hieunguyenvd/250W-24V-to-48V-Synchronous-DC-DC-Boost-Converter-/3D Model.png

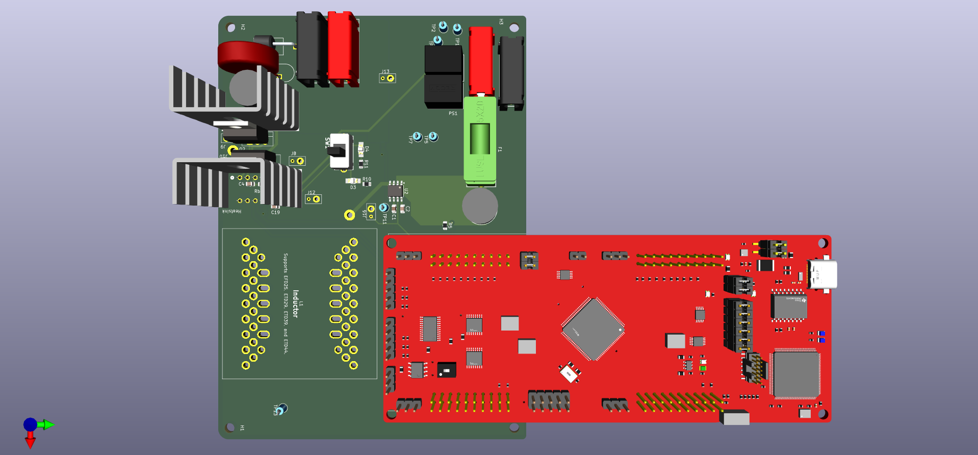
3D Model.png
