hieunguyenvd/250W-24V-to-48V-Synchronous-DC-DC-Boost-Converter-/Highlighted Overall Layout.png

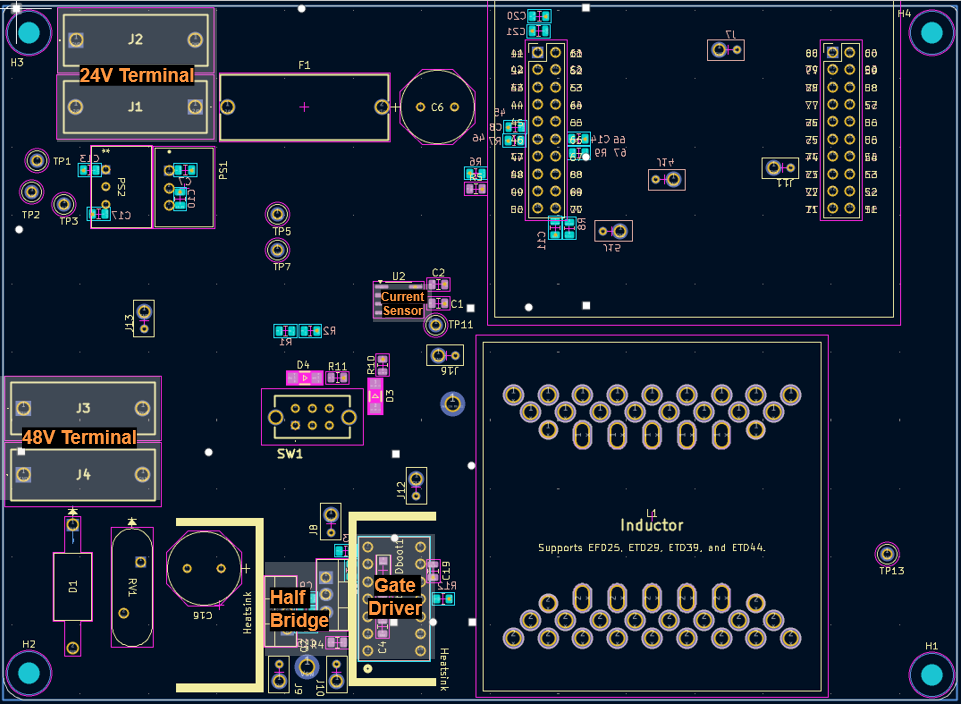
Highlighted Overall Layout.png
