hieunguyenvd/250W-24V-to-48V-Synchronous-DC-DC-Boost-Converter-/(list of files, cad)

Other CAD files:
adc_ex1_soc_epwm/CPU1_FLASH/f28p55x_codestartbranch.obj
adc_ex1_soc_epwm/CPU1_RAM/f28p55x_epwm.obj
adc_ex1_soc_epwm/CPU1_FLASH/f28p55x_sysctrl.obj
adc_ex1_soc_epwm/CPU1_RAM/f28p55x_usdelay.obj
adc_ex1_soc_epwm/CPU1_FLASH/f28p55x_usdelay.obj
adc_ex1_soc_epwm/CPU1_RAM/f28p55x_cputimers.obj
adc_ex1_soc_epwm/CPU1_FLASH/f28p55x_adc.obj
adc_ex1_soc_epwm/CPU1_RAM/f28p55x_pievect.obj
adc_ex1_soc_epwm/CPU1_FLASH/f28p55x_globalvariabledefs.obj
adc_ex1_soc_epwm/CPU1_RAM/f28p55x_sysctrl.obj
adc_ex1_soc_epwm/CPU1_FLASH/f28p55x_tempsensorconv.obj
adc_ex1_soc_epwm/CPU1_RAM/f28p55x_defaultisr.obj
adc_ex1_soc_epwm/CPU1_FLASH/f28p55x_defaultisr.obj
adc_ex1_soc_epwm/CPU1_RAM/f28p55x_tempsensorconv.obj
adc_ex1_soc_epwm/CPU1_FLASH/f28p55x_gpio.obj
adc_ex1_soc_epwm/CPU1_RAM/adc_ex1_soc_epwm.obj
adc_ex1_soc_epwm/CPU1_FLASH/adc_ex1_soc_epwm.obj
adc_ex1_soc_epwm/CPU1_RAM/f28p55x_adc.obj
adc_ex1_soc_epwm/CPU1_FLASH/f28p55x_dma.obj
adc_ex1_soc_epwm/CPU1_RAM/f28p55x_codestartbranch.obj
adc_ex1_soc_epwm/CPU1_FLASH/f28p55x_piectrl.obj
adc_ex1_soc_epwm/CPU1_RAM/f28p55x_globalvariabledefs.obj
adc_ex1_soc_epwm/CPU1_FLASH/f28p55x_cputimers.obj
adc_ex1_soc_epwm/CPU1_RAM/f28p55x_gpio.obj
adc_ex1_soc_epwm/CPU1_FLASH/f28p55x_epwm.obj
adc_ex1_soc_epwm/CPU1_RAM/f28p55x_piectrl.obj
adc_ex1_soc_epwm/CPU1_FLASH/f28p55x_pievect.obj
adc_ex1_soc_epwm/CPU1_RAM/f28p55x_dma.obj
