hieunguyenvd/250W-24V-to-48V-Synchronous-DC-DC-Boost-Converter-/Lab2_starter.kicad_pcb

## KiCad design Lab2_starter.kicad_pcb (2025-12-30)

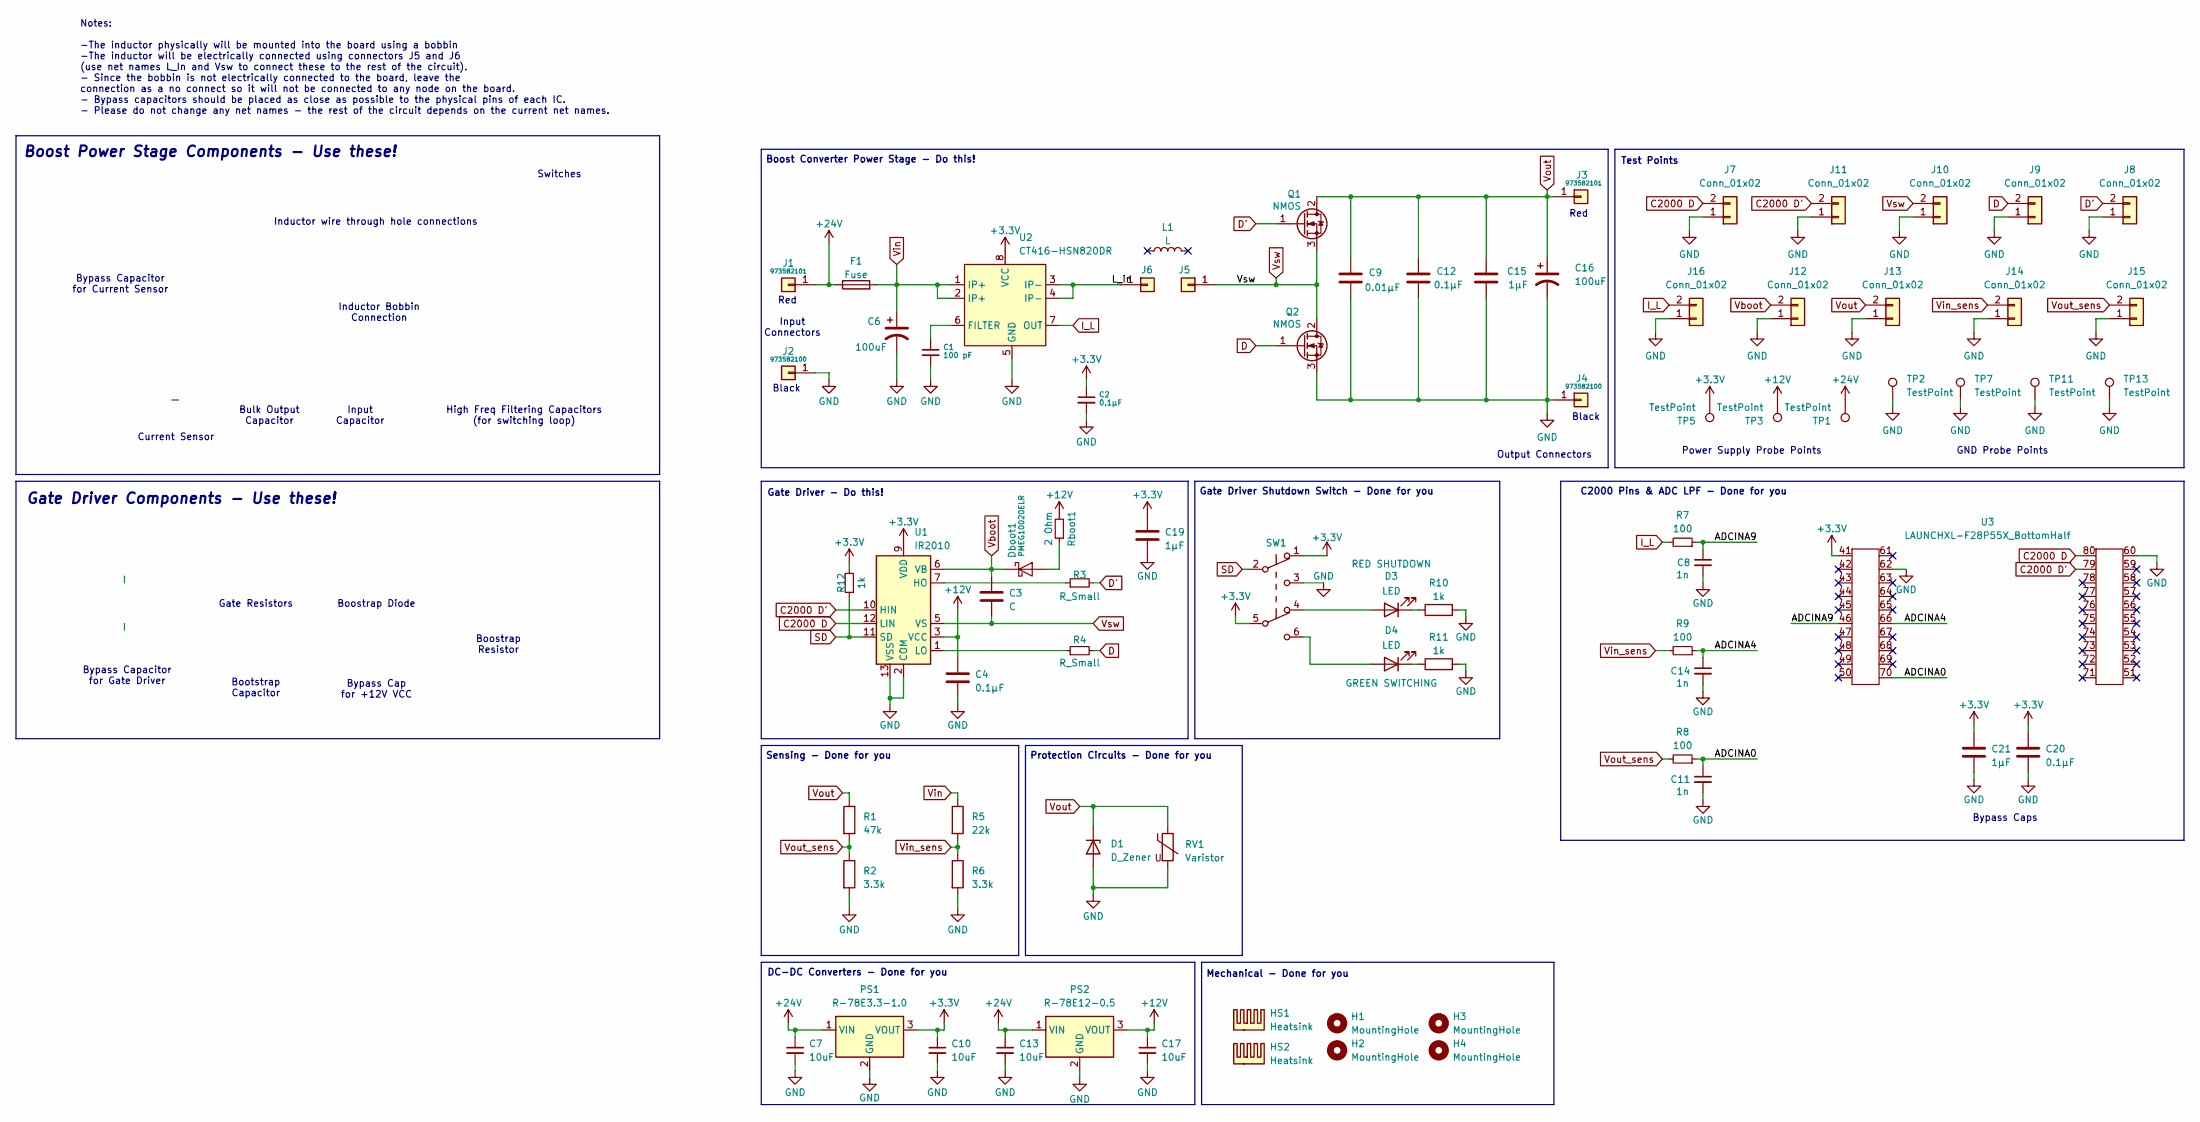
[picture p28: schematic Lab2_starter.kicad_sch, 24V-48V Boost Converter]

Parts:
C1: 100 pF; C_0805_2012Metric
C2, C4, C12, C20: 0.1μF; C_0805_2012Metric
C3: C; C_0805_2012Metric
C6, C16: 100uF; 16PX2200MEFC10X20
C7, C10, C13, C17: 10uF; C_0805_2012Metric
C8, C11, C14: 1n; C_0805_2012Metric
C9: 0.01μF; C_0805_2012Metric
C15, C19, C21: 1μF; C_0805_2012Metric
D1: D_Zener; 1.5KE75A
D3, D4: LED; WL-SMRW_1206_REC
Dboot1: PMEG10020ELR; Nexperia_CFP3_SOD-123W
F1: Fuse; 696108003002
H1, H2, H3, H4: MountingHole; MountingHole_3.2mm_M3
HS1, HS2: Heatsink; HSS-B20-NPS-01
J1, J3: 973582101
J2, J4: 973582100
J5, J6: Conn_01x01; Inductor_wire_conn
J7, J8, J9, J10, J11, J12, J13, J14, J15, J16: Conn_01x02; TP
L1: L; Inductor
PS1: R-78E3.3-1.0; PARTREV 6
PS2: R-78E12-0.5; R-78E-0.5_RCP
Q1, Q2: NMOS; TO-220-3_Vertical
R1: 47k; R_0805_2012Metric
R2, R6: 3.3k; R_0805_2012Metric
R3, R4: R_Small; R_0805_2012Metric
R5: 22k; R_0805_2012Metric
R7, R8, R9: 100; R_0805_2012Metric
R10, R11, R12: 1k; R_0805_2012Metric
RV1: Varistor; V100ZA15P
Rboot1: 2 Ohm; R_0805_2012Metric
SW1: SW_Push_DPDT; SLW1116297AD
TP1, TP2, TP3, TP5, TP7, TP11, TP13: TestPoint; TestPoint_Loop_D1.80mm_Drill1.0mm_Beaded
U1: IR2010; 1-2199298-3
U2: CT416-HSN820DR; SOIC-8_3.9x4.9mm_P1.27mm
U3: LAUNCHXL-F28P55X_BottomHalf

Connections:
+3.3V: C2.1, C10.1, C19.1, C20.1, C21.1, PS1.3 (VOUT), R12.2, SW1.1 (A), SW1.5 (B), TP5.1, U1.9 (VDD), U2.8 (VCC), U3.41
+12V: C4.1, C17.1, PS2.3 (VOUT), Rboot1.2, TP3.1, U1.3 (VCC)
+24V: C7.1, C13.1, F1.1, J1.1, PS1.1 (VIN), PS2.1 (VIN), TP1.1
/ADCINA0: C11.1, R8.1, U3.70
/ADCINA4: C14.1, R9.1, U3.66
/ADCINA9: C8.1, R7.1, U3.46
C2000 D: J7.2, U1.12 (LIN), U3.80
C2000 D': J11.2, U1.10 (HIN), U3.79
D: J9.2, Q2.1 (G), R4.2
D': J8.2, Q1.1 (G), R3.2
GND: C1.2, C2.2, C4.2, C6.2, C7.2, C8.2, C9.2, C10.2, C11.2, C12.2, C13.2, C14.2, C15.2, C16.2, C17.2, C19.2, C20.2, C21.2, D1.2 (A), J2.1, J4.1, J7.1, J8.1, J9.1, J10.1, J11.1, J12.1, J13.1, J14.1, J15.1, J16.1, PS1.2 (GND), PS2.2 (GND), Q2.3 (S), R2.2, R6.2, R10.2, R11.2, RV1.2, SW1.3 (C), TP2.1, TP7.1, TP11.1, TP13.1, U1.2 (COM), U1.13 (VSS), U2.5 (GND), U3.60, U3.62
I_L: J16.2, R7.2, U2.7 (OUT)
unnamed: D3.2 (A), SW1.4 (A)
unnamed: D3.1 (K), R10.1
unnamed: D4.2 (A), SW1.6 (C)
unnamed: D4.1 (K), R11.1
unnamed: Dboot1.2 (A), Rboot1.1
unnamed: J6.1, U2.3 (IP-), U2.4 (IP-)
unnamed: R3.1, U1.7 (HO)
unnamed: R4.1, U1.1 (LO)
unnamed: C1.1, U2.6 (FILTER)
SD: R12.1, SW1.2 (B), U1.11 (SD)
Vboot: C3.1, Dboot1.1 (K), J12.2, U1.6 (VB)
Vin: C6.1, F1.2, R5.1, U2.1 (IP+), U2.2 (IP+)
Vin_sens: J14.2, R5.2, R6.1, R9.2
Vout: C9.1, C12.1, C15.1, C16.1, D1.1 (K), J3.1, J13.2, Q1.2 (D), R1.1, RV1.1
Vout_sens: J15.2, R1.2, R2.1, R8.2
Vsw: C3.2, J5.1, J10.2, Q1.3 (S), Q2.2 (D), U1.5 (VS)

Notes on the sheet:
High Freq Filtering Capacitors (for switching loop)
Inductor wire through hole connections
Input Connectors
Sensing - Done for you
Protection Circuits - Done for you
Input Capacitor
Test Points
Bypass Cap for +12V VCC
Black
Mechanical - Done for you
Red
Bulk Output Capacitor
Power Supply Probe Points
Bootstrap Capacitor
Gate Driver Shutdown Switch - Done for you
Notes: -The inductor physically will be mounted into the board using a bobbin -The inductor will be electrically connected using connectors J5 and J6 (use net names L_In and Vsw to connect these to the rest of the circuit). - Since the bobbin is not electrically connected to the board, leave the co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
Gate Driver - Do this!
Current Sensor
Boostrap Resistor
DC-DC Converters - Done for you
Boost Power Stage Components - Use these!
Gate Resistors
C2000 Pins & ADC LPF - Done for you
Boostrap Diode
Output Connectors
Bypass Capacitor for Current Sensor
Inductor Bobbin Connection
Switches
Bypass Capacitor for Gate Driver
Gate Driver Components - Use these!
GND Probe Points
Bypass Caps
Boost Converter Power Stage - Do this!

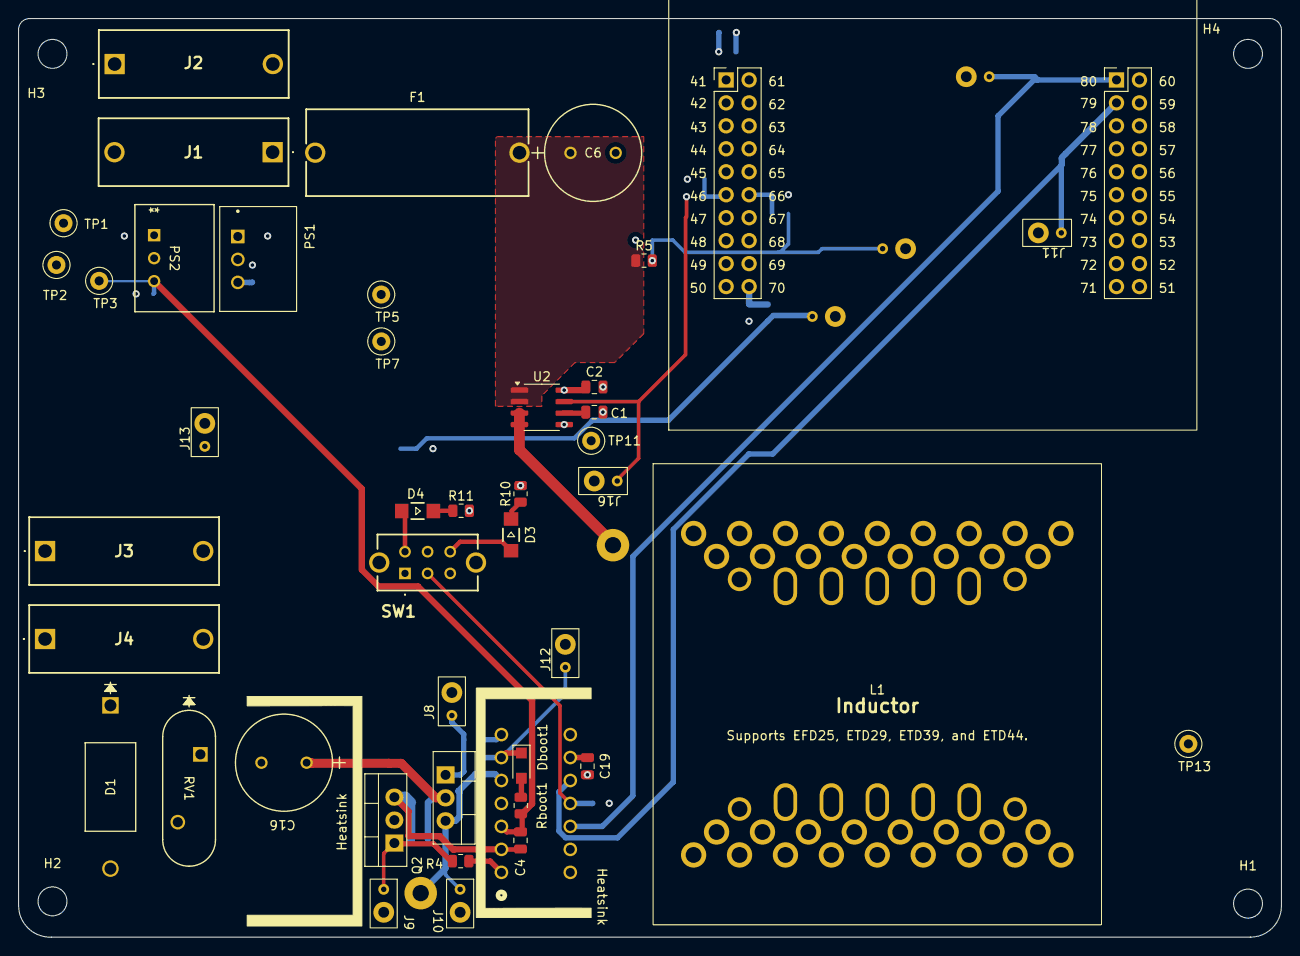
[picture p29: board Lab2_starter.kicad_pcb from above]

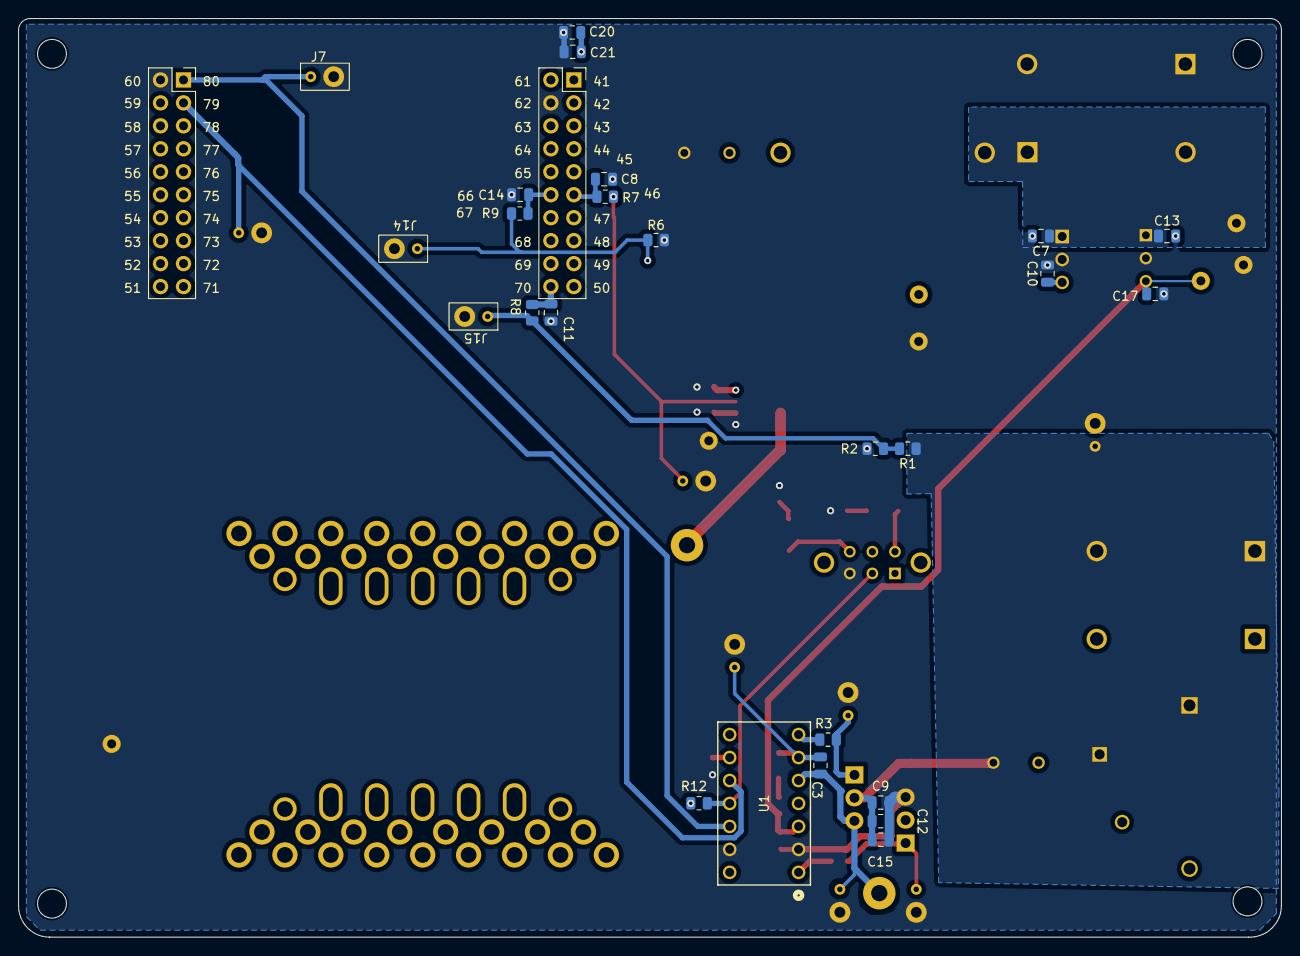
[picture p30: board Lab2_starter.kicad_pcb from below]

Board: 4 copper layers, 139.7 x 101.6 mm, 76 parts (25 on the bottom side), 28 nets.
