hieunguyenvd/250W-24V-to-48V-Synchronous-DC-DC-Boost-Converter-/(notices)

Notices in the files:
parts and their libraries:
Copyright 2016 Accelerated Designs. All rights reserved.
